spalk/cacti-env/devices/main-device/README.md

## Main Device information

- core: ESP32 Microcontloller in devkit formfactor
- display: Nokia 5110
- 2 light sensors: BH1750 
- 2 soil moisture sensors: analog capacitive 
- temperature sensor for outside: DB18b20
- pressure, humidity, temperature sensor: BME280
- 1 sensor button for display backlight on/off 
- two output blocks for relay control

### Schemactic: 
Cacti-Env Main Device schematic

### PCB Prototype:
Cacti-Env Main Device PCB Front Side
Cacti-Env Main Device PCB Back Side

### Real PCB:
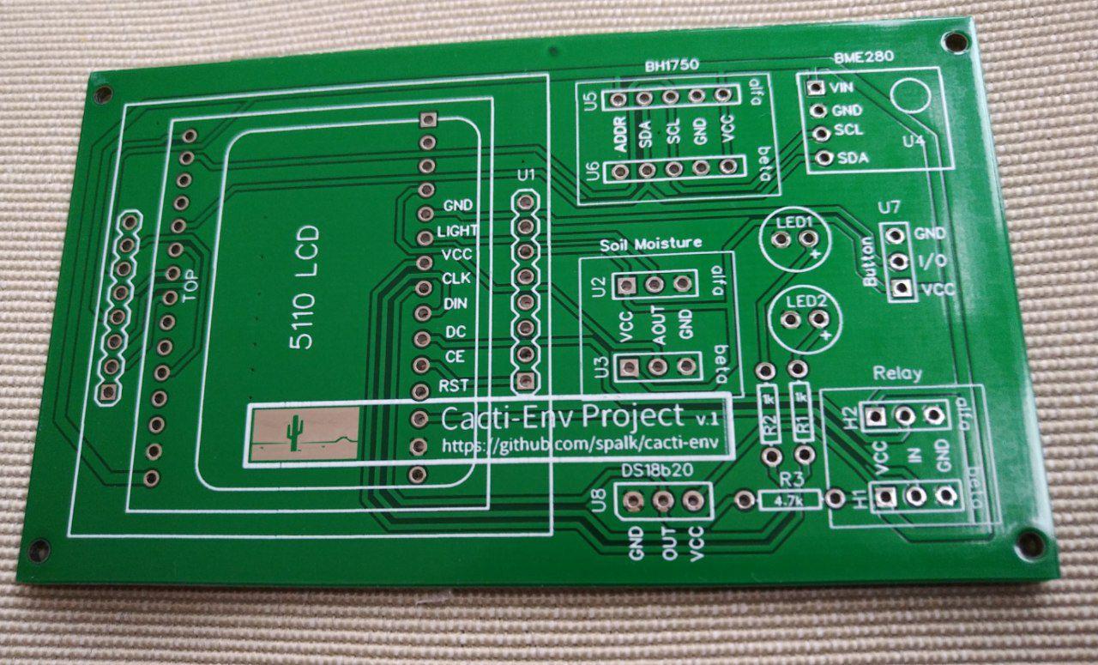
[picture p7: devices/main-device/static/real_PCB_front.jpg]
Cacti-Env Main Device Real PCB Front Side

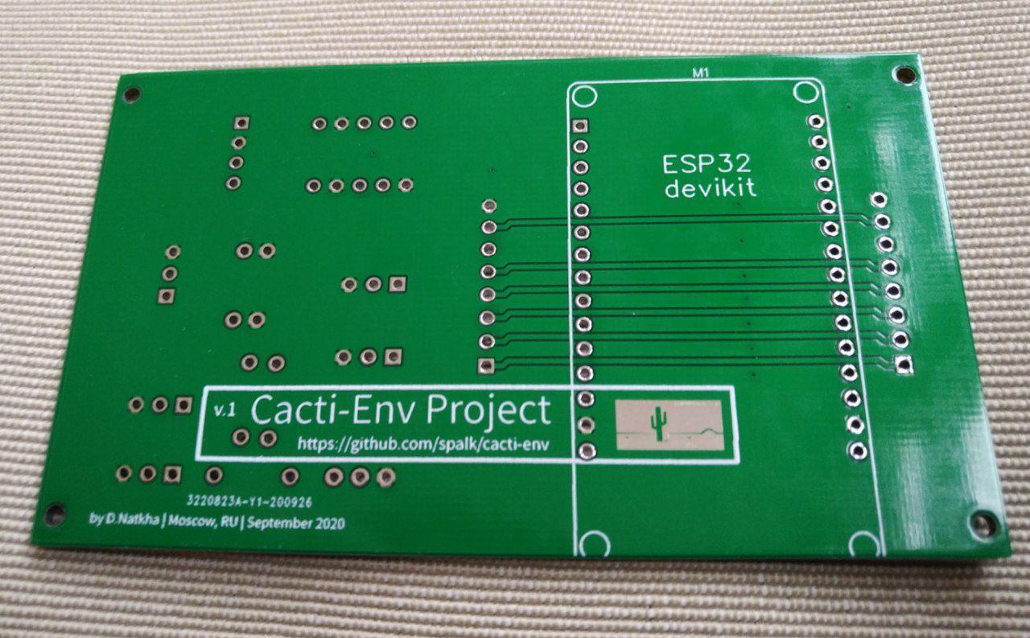
[picture p8: devices/main-device/static/real_PCB_back.jpg]
Cacti-Env Main Device Real PCB Back Side


### First assembly
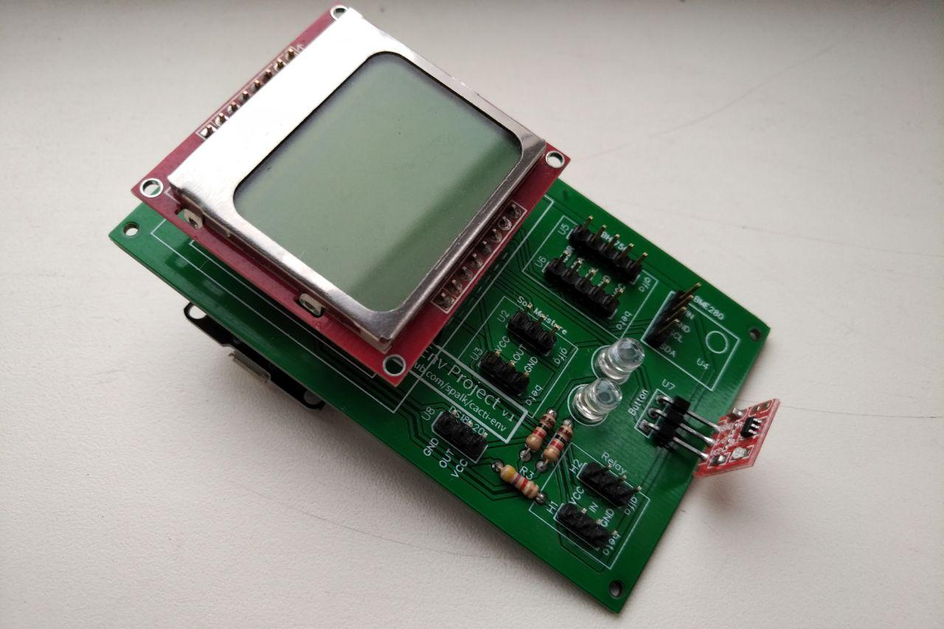
[picture p9: devices/main-device/static/first_assembly.jpg]
Cacti-Env Main Device First Assembly
  
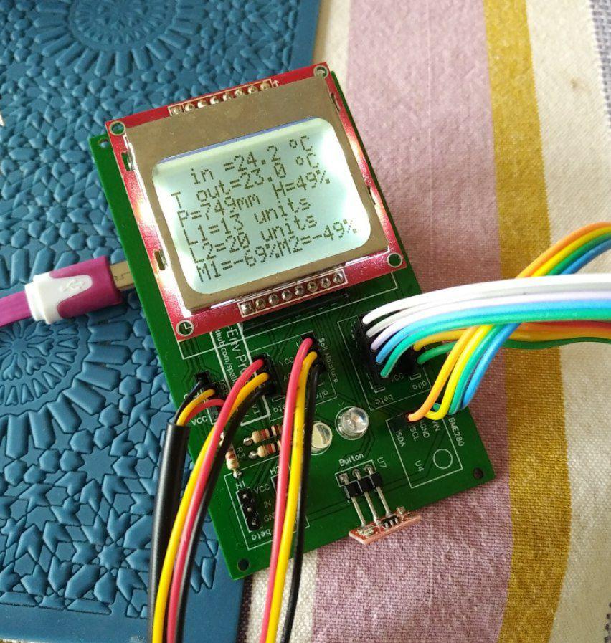
[picture p10: devices/main-device/static/first_assembly_working.jpg]
Cacti-Env Main Device First Assembly Working
