spalk/cacti-env/article.md

Преследуюемые цели: 
1. Наблюдение за температурой. Я живу в северных широтах, температура зимой достигает -30 градусов на улице. Помещение, где стоят растения не имеет серьезного утепления, поэтому переход значения в отрицательную зону здесь тоже возможен. В свою очередь летом маленькая площадь за стеклом может прогреваться до 30 градусов и выше без должного проветривания. 
2. Наблюдение за освещением. По той же причине, северного географического расположения, естественного света не хватает из-за короткой продолжительности светового дня либо большого количества пасмурных дней. Городская застройка также перманентно ограничивает доступ прямых световых лучей в направлении близко стоящих зданий. 
3. Наблюдение за влажностью грунта. Отсуствие большого опыта использования полностью минеральных субстратов не позволяет достоверно оценить состояние грунта. Быстрое просыхание верхних слоёв может создать обманчивое впечатление просыхания полного, результатом чего может стать перелив, критически нежелательный для суккулентов. 
4. Автоматизация. В зависимости от состояния вышеперечисленных параметров, необходима возможность управлять какими-либо устройствами: обогреватель, вентилятор, лампа освещения и т.д.
5. Оповещение. Возможность информирования о рядовых (включение/выключение прибора) или кртических (критические значения каких-то параметрров) событиях.
