spalk/cacti-env/node-red_flows/auto_grow_light/auto_grow_light.png

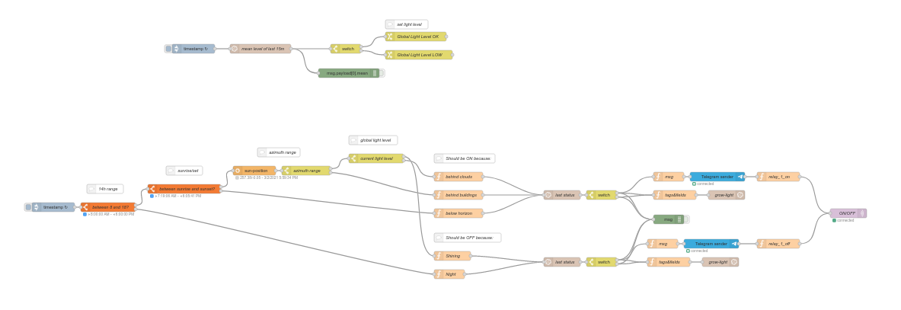
node-red_flows/auto_grow_light/auto_grow_light.png
