spalk/cacti-env/node-red_flows/bedroom/bedroom.png

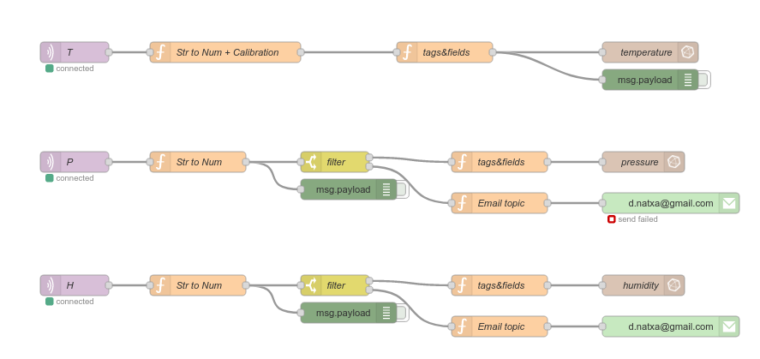
node-red_flows/bedroom/bedroom.png
