spalk/cacti-env/node-red_flows/narodmon/narodmon.png

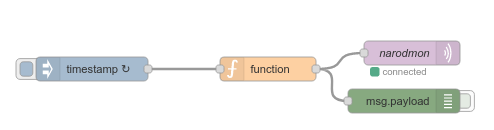
node-red_flows/narodmon/narodmon.png
