spalk/cacti-env/node-red_flows/sensors/sensors.png

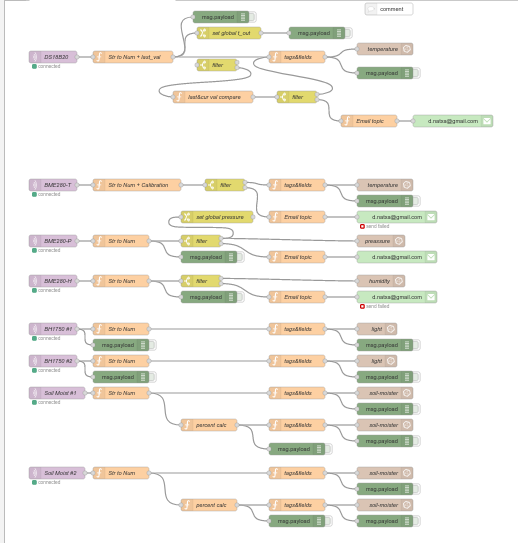
node-red_flows/sensors/sensors.png
