spalk/cacti-env/node-red_flows/sun/sun.png

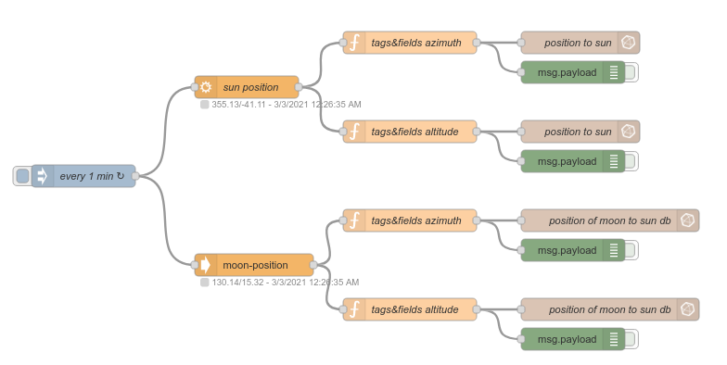
node-red_flows/sun/sun.png
