spalk/cacti-env/(threads)

Thread 1 (2021-01-30):

Freezes without internet

spalk, 2021-01-30:
If internet was temporarily unavailable or wifi-router was rebooted, the device is freezing and can't resume working when connection was restored.
