spalk/cacti-env/devices/main-device/static/Schematic.pdf

## I2C sensors:

## Display

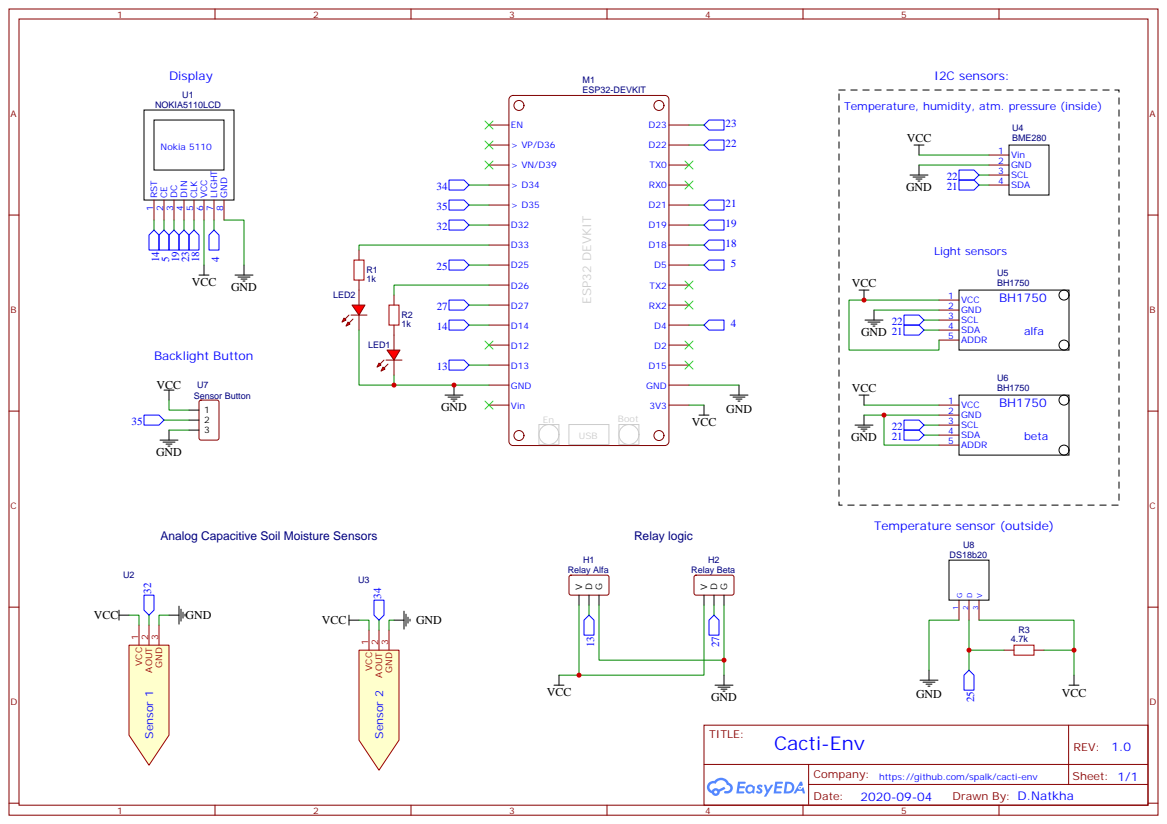
[picture p16: page 1]

Temperature, humidity, atm. pressure (inside)

Analog Capacitive Soil Moisture Sensors

Company: https://github.com/spalk/cacti-env
