spalk/cacti-env/(commit log)

2020-08-21 multi sensor platform (no wifi )
2020-09-19 wemos esp8266 informer migration from WSS project to cacti-env project data source is MQTT server + personal sensors
2020-09-20 indoor bme280 sensor based device (bedroom for now)
2020-09-20 show pressure diff in comparison to yesterday value at the same time
2020-09-25 Main Device Schematic and PCB
2020-10-13 photos of real PCB and first assembly
2020-10-18 1. new app structure 2. separate libs created: Sensors and Display 3. new icons on display 4. new welcome screen
2020-10-20 average getter for analogRead sensors (Soil Moisture)
2020-10-21 led class added display show val for unavailable sensors bugfix
    [CACTI-ENV.ino, Display.cpp, Display.h, LED.cpp, LED.h, MQTT.cpp, MQTT.h, OTA.h]
2020-10-23 Backlight sensor button works!
2020-10-23 Relay module + contrlolling via MQTT (looks like not enough voltage for 2 relay)
2020-11-05 structure of folders for devices refactoring
2020-11-08 static images of devices added
2020-11-10 bme280 t calibration on display
2020-11-10 publisher device photo and small description
2020-11-11 relay is off by default
2021-03-02 add: node-red flows + screenshots
